jw364/e-paper-esp32-frame/(commit log)

2026-06-10 Redesign firmware for LILYGO T7-S3 + 3.6" E Ink Spectra 6 (E6) display
    Hardware changes from the original project:
    - MCU: FireBeetle ESP32-E → LILYGO T7-S3 V1.1 (ESP32-S3, 16 MB flash)
    - Display: 7.3" 800×480 → 3.6" 600×400 Spectra 6 (E6)
    - Storage: SD card → LittleFS on the internal 16 MB flash
    - New driver epd3in6e.h/cpp replaces epd7in3combined (same UC8253 controller,
    resolution adjusted to 600×400 in command 0x61)
    - epdif updated to use ESP32-S3 FSPI bus (GPIO 8-12 for HAT+ Standard board)
    Firmware behaviour:
    - Stores 50 pre-dithered 4-bit .bin images in LittleFS:
    /a0/00-24.bin (Album 0) and /a1/00-24.bin (Album 1)
    - Wakes from deep sleep every hour (RTC timer) and advan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
    [partitions.csv]
2026-06-17 Migrate to LILYGO T7 S3 V1.1 (ESP32-S3) with two-album switching
    Hardware changes:
    - Board: FireBeetle 2 ESP32-E → LILYGO T7 S3 V1.1 (ESP32-S3)
    - Display SPI: HSPI (pins 21/22) → FSPI/SPI2 (GPIO12/11), resolves pin conflict
    - SD card SPI: now on dedicated HSPI/SPI3 bus (GPIO4-7) separate from display
    - MOSFET: GPIO26 → GPIO16 (safe GPIO, avoids strapping pins)
    - Battery ADC: GPIO34 (ESP32 only) → GPIO2 (T7 S3 onboard divider)
    - ADC API: deprecated esp_adc_cal → analogReadMilliVolts() (native S3 calibration)
    New feature: two-album switching
    - Albums stored in /albumA/ and /albumB/ on SD card
    - Hold button (GPIO1) ≥2.5s, release, press twice within 3s each to switch
    - Short presse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
    [e-paper-esp32-frame.ino, epdif.cpp, epdif.h]
2026-06-17 Rewrite README with full wiring diagrams, power budget, and album docs
2026-06-17 Add Wokwi simulation config and fix EPD busy timeout
    - diagram.json: ESP32-S3 board + pushbutton (GPIO1) + 10kΩ BUSY
    pull-up (GPIO15→3V3) + SD card wired to HSPI (GPIO4-7)
    - wokwi.toml: points to build/ ELF/BIN; documents compile steps
    - libraries.txt: ArduinoJson dependency for Wokwi CI
    - sdcard/: test SD card tree with setup.json (Wokwi-GUEST WiFi),
    albumA/info.txt, albumB/info.txt, albumA/test.bmp (4×4 24-bit BMP)
    - epd7in3combined.cpp: add 30s timeout to EPD_7IN3F_BusyHigh() to
    prevent infinite loop when no physical display drives BUSY HIGH
    - epdif.cpp / .ino: defensive #ifndef guards for FSPI/HSPI constants
    [e-paper-esp32-frame.ino, epd7in3combined.cpp, epdif.cpp]
2026-06-17 Rework album-switch sequence to shared 5-second verification window
    Previous logic gave each confirmation press its own separate 3-second
    timeout, so the two presses were independent. The new behavior requires
    both presses to fall within a single 5-second window that starts when
    the hold is released — matching the specified UX:
    1. Hold > 2 s → release
    2. A 5-second window opens
    3. Press twice inside that window → album switches
    Changes:
    - ALBUM_HOLD_DURATION_MS: 2500 → 2000 (ms)
    - ALBUM_CONFIRM_WINDOW_MS: 3000 → 5000 (ms, now shared across both presses)
    - checkAndHandleAlbumButton(): records windowStart once; each press check
    computes remaining time from that single a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
    [e-paper-esp32-frame.ino]
2026-06-18 Add GitHub Actions CI, Wokwi scenario, and fix board config
    GitHub Actions ci.yml: compiles sketch with arduino-cli and runs Wokwi CI
    album-switch scenario (gated on WOKWI_ENABLED var + WOKWI_CLI_TOKEN secret).
    scenario.yaml: presses GPIO1 LOW at t=0, holds 2.2s, releases, sends two
    confirmation presses within the 5-second shared window, asserts ALBUM SWITCHED.
    wokwi.toml: added scenario key; expanded compile instructions.
    libraries.txt: pinned ArduinoJson to v6.21.5 (v7 removed DynamicJsonDocument).
    .vscode/arduino.json: fixed PartitionScheme from default_16MB to
    app3M_fat9M_16MB which is valid in esp32 core v3.x.
2026-07-01 Migrate MCU from LILYGO T7 S3 (ESP32-S3) to FireBeetle 2 ESP32-E
    Key changes:
    - epdif.h / epdif.cpp: switch SPI bus from FSPI (ESP32-S3 only) to VSPI
    (SPI2 on original ESP32); reassign EPD pins to VSPI defaults:
    SCK=18, MOSI=23, CS=5, DC=27, RST=26, BUSY=25
    - e-paper-esp32-frame.ino: reassign all GPIOs to avoid flash-reserved
    pins (GPIO 6-11 cannot be used on ESP32):
    SD: SCLK=14, MOSI=13, MISO=4, CS=33
    MOSFET: GPIO21, BUTTON: GPIO22, BAT_ADC: GPIO36
    Remove HSPI=1 fallback (not needed on ESP32 core 3.x)
    Increase power-on stabilisation delay from 20ms to 50ms
    - .vscode/arduino.json: update FQBN to dfrobot_firebeetle2_esp32e,
    remove ESP32-S3-specific settings (OPI PSRAM, 16MB fl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
    [e-paper-esp32-frame.ino, epdif.cpp, epdif.h]
2026-07-01 ci: pin esp32:esp32 core to 3.3.10, add verbose compile, add diagnostics
    - Pin core to 3.3.10 (matches local build that compiles successfully)
    - Add --verbose to compile step to surface exact error in CI logs
    - Add 'board details' step to verify FQBN resolves before compile
    - Add 'arduino-cli version' step for environment diagnostics
2026-07-01 fix: correct Arduino.h include case in epdif.h (Linux case-sensitive)
    Lowercase '#include <arduino.h>' causes a fatal error on Linux
    (case-sensitive filesystem) but compiles silently on Windows.
    Fatal error: arduino.h: No such file or directory
    [epdif.h]
2026-07-12 Switch refresh cadence from daily to hourly, decouple WiFi/NTP from wake
    Hourly wakes now sleep to the next REFRESH_INTERVAL_HOURS boundary
    instead of targeting a fixed 10:00 AM daily wake. WiFi/NTP is only
    contacted on first boot / after power loss and every
    NTP_SYNC_EVERY_N_WAKES wakes thereafter (~daily); all other wakes read
    the RTC-backed system clock directly with no WiFi, tracked via a wake
    counter and sync flag persisted in RTC memory across deep sleep.
    Also adds optional quiet hours (QUIET_HOURS_ENABLED/START/END) that
    skip the refresh and sleep straight through a configured window, and
    removes the old "before 09:00 show yesterday" hack from date-pinned
    image matching, which no lon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
    [e-paper-esp32-frame.ino, time_utils.cpp, time_utils.h]
2026-07-12 Update README for hourly cadence, 1200mAh battery, and MOSFET sourcing
    Reflects the finalized build: AO3401 SOT-23 MOSFET on a breakout board
    (with sourcing, pinout, bench-test, and TO-92-substitute warning notes),
    3.7V 1200mAh 603450 LiPo with PCM protection (plus a JST polarity
    warning), and a recommended panel-mount toggle switch in series with
    the battery positive lead.
    Adds a "Low Power" solder-pad cut step (WS2812 controller draws ~500uA
    continuously otherwise) and rewrites the power budget for hourly
    refreshes (~2 months/charge) vs. the old daily-refresh math, with a
    cadence comparison table and a list of the mitigations the firmware
    already implements (WiFi mostly skipped, optional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
2026-07-23 Support multi-network WiFi, fix top-down BMP handling, untrack build artifacts
    - setup.json / time_utils.cpp: initializeWifi() now accepts a
    "networks" array and tries each in order, so the frame can roam
    between known WiFi networks instead of hardcoding a single SSID.
    - e-paper-esp32-frame.ino: drawBmp() previously read BMP height as
    unsigned, which silently produced a blank/white screen for any
    top-down (negative-height) BMP. Height is now read as signed, and
    top-down files are handled by seeking rows in reverse.
    - e-paper-esp32-frame.ino: checkSDFiles() now skips hidden/AppleDouble
    files (e.g. "._cat.bmp") that macOS drops onto FAT volumes, which
    were previously scanned in a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
    [e-paper-esp32-frame.ino, time_utils.cpp]
